alxlab-zone66x/Macintosh-Comm-Slot-I-Ethernet-Card/kicad/Farallon EtherMac LC Comm Slot Card 10Base-T/Farallon EtherMac LC Comm Slot Card 10Base-T v1.0.kicad_sch

## KiCad design kicad/Farallon EtherMac LC Comm Slot Card 10Base-T/Farallon EtherMac LC Comm Slot Card 10Base-T v1.0.kicad_sch (2024-09-20, an earlier design)

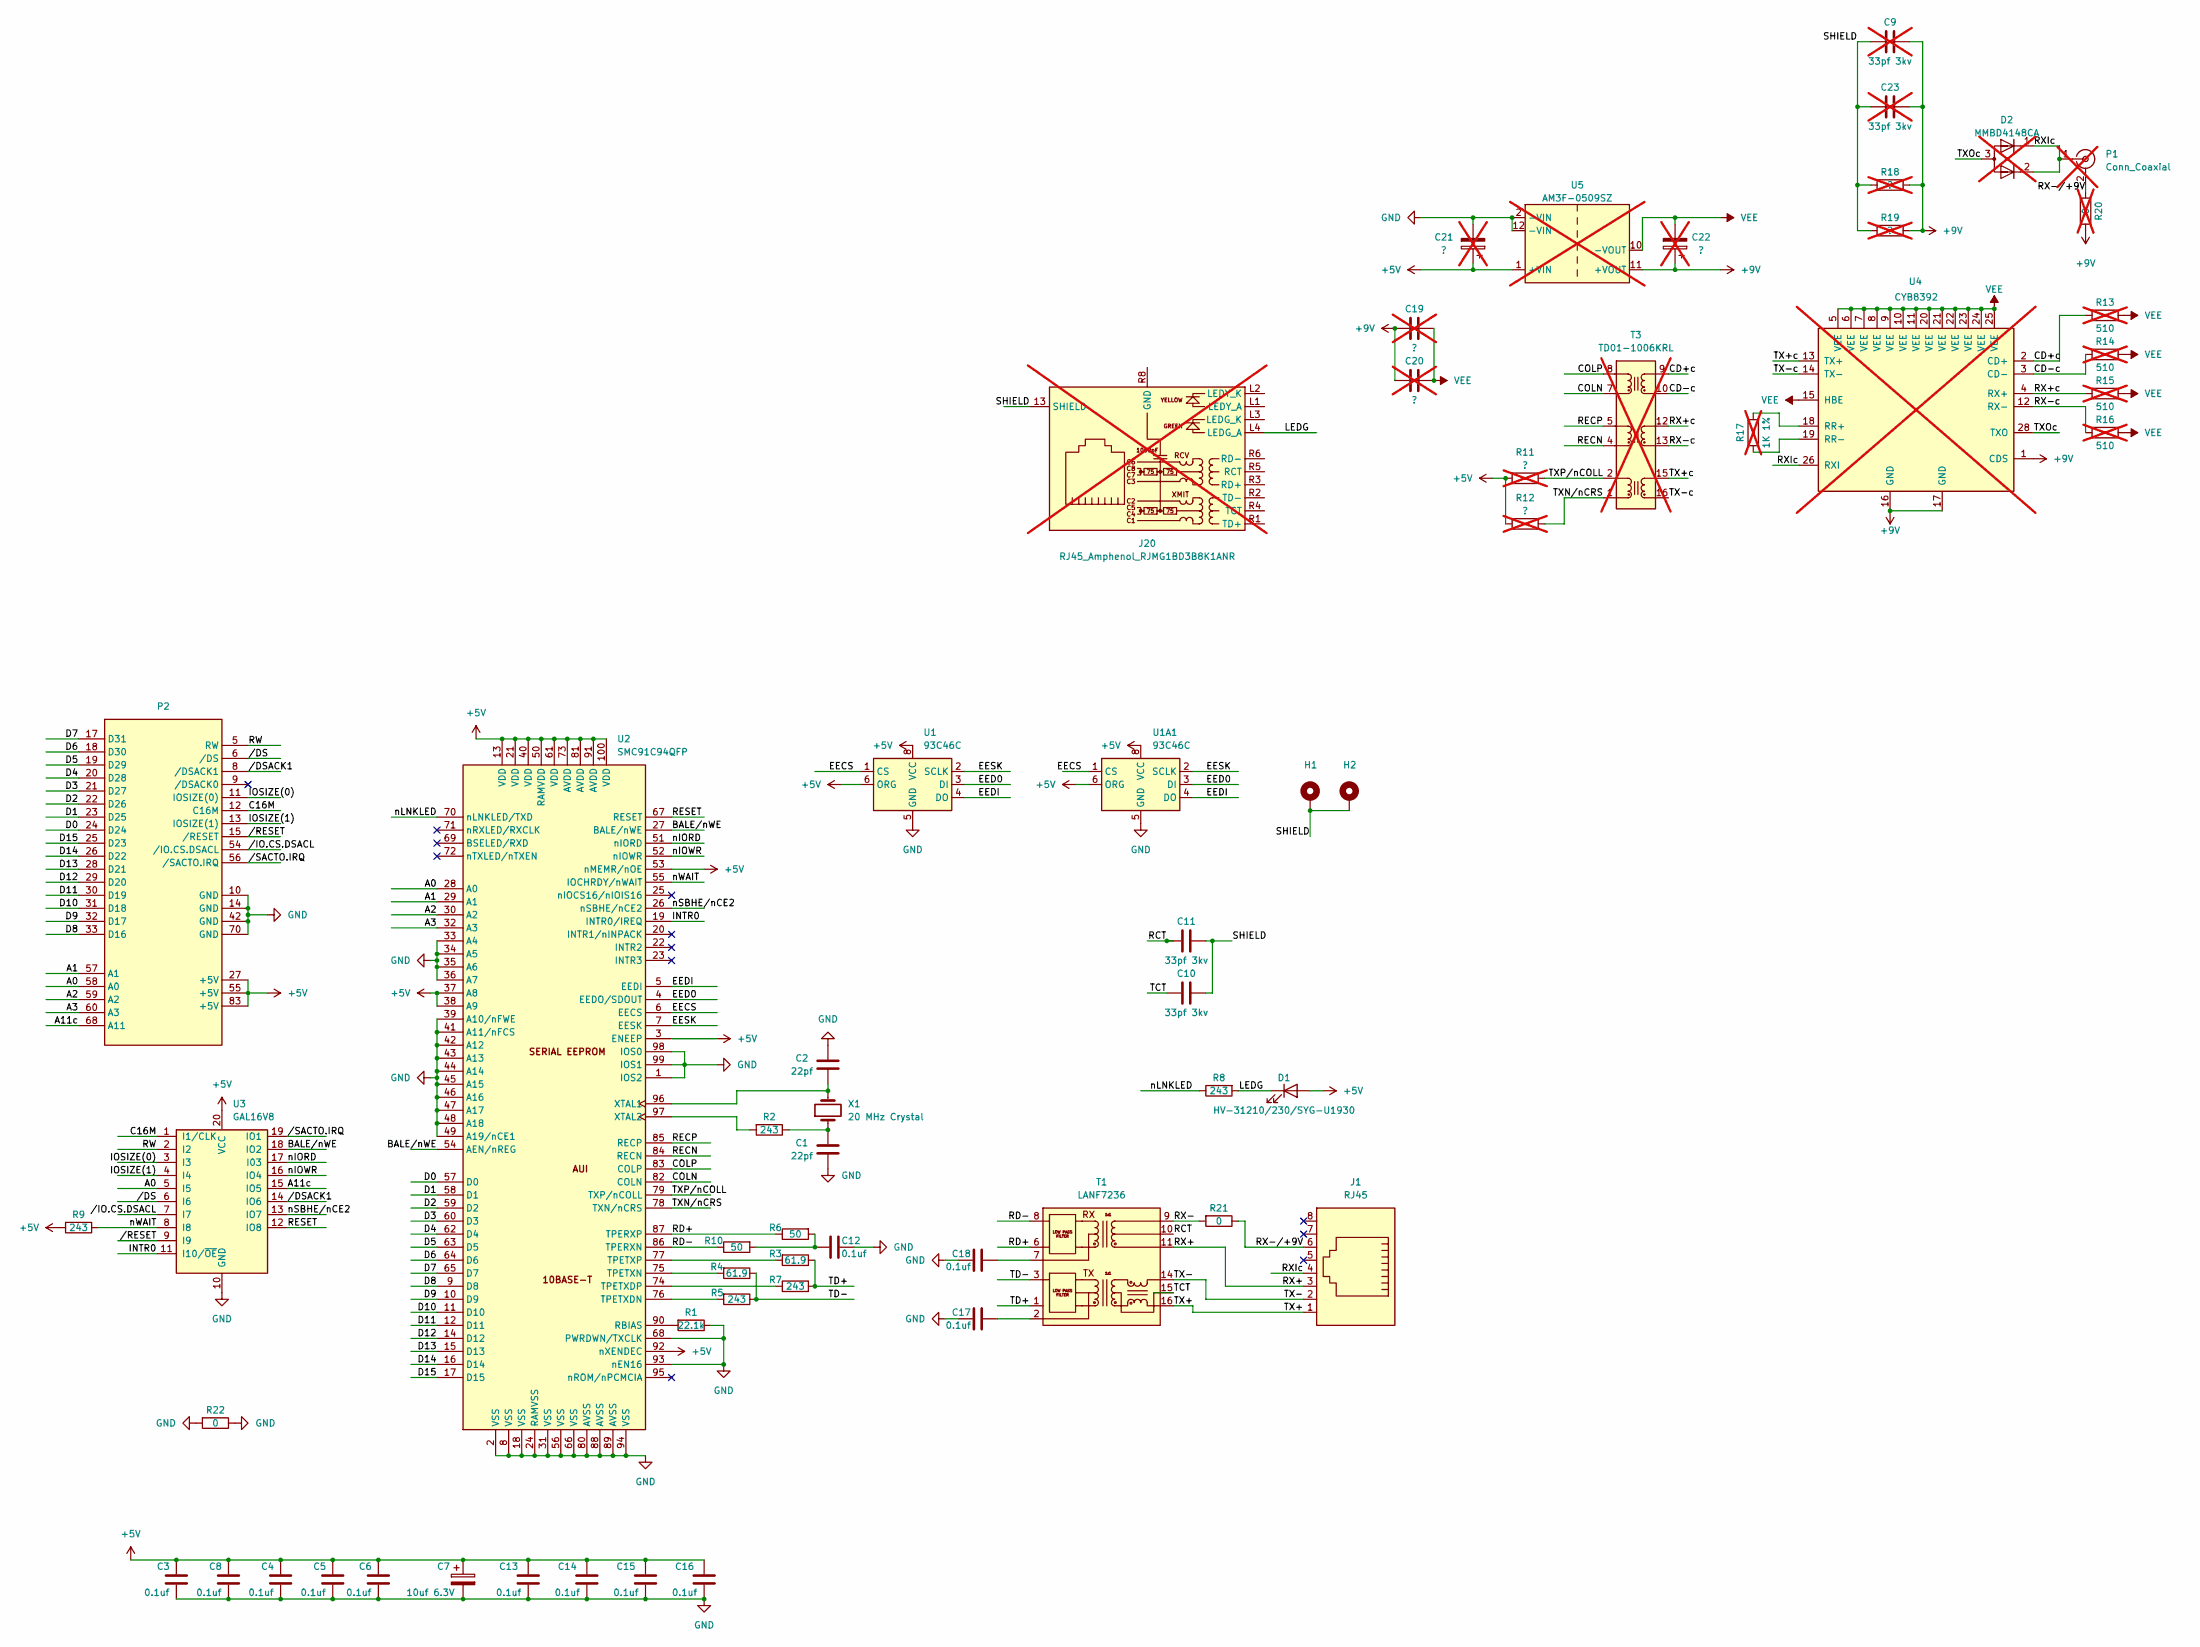
[picture p1: schematic Farallon EtherMac LC Comm Slot Card 10Base-T v1.0.kicad_sch]

Parts:
C1, C2: 22pf; Farallon_C_0603_1608Metric_Pad1.10x1.20mm_HandSolder; LCSC C1653
C3, C4, C5, C6, C8, C12, C13, C14, C15, C16, C17, C18: 0.1uf; Farallon_C_0603_1608Metric_Pad1.10x1.20mm_HandSolder; LCSC C14663
C7: 10uf 6.3V; Farallon_CP_EIA-3528-21_Kemet-B_Pad1.50x2.35mm_HandSolder; LCSC C7193
C9, C23: 33pf 3kv; C_Disc_D6.0mm_W2.5mm_P6.35mm; not fitted
C10, C11: 33pf 3kv; C_Disc_D6.0mm_W2.5mm_P6.35mm; LCSC C260735
C19, C20: ?; Farallon_C_0603_1608Metric_Pad1.10x1.20mm_HandSolder; not fitted
C21, C22: ?; Farallon_CP_Radial_D7.5mm_P3.0mm; not fitted
D1: HV-31210/230/SYG-U1930; LED_HV-31210-230-SYG-U1930; LCSC C473838
D2: MMBD4148CA; Farallon_SOT-23; not fitted
H1, H2: MountingHole_Pad; MountingHole_3.2mm_M3_ISO7380_Pad_TopBottom
J1: RJ45; Farallon_RJ45_BNC_Amphenol_54602-x08_Horizontal; Part 5555164-1; LCSC C2916457
J20: RJ45_Amphenol_RJMG1BD3B8K1ANR; not fitted
P1: Conn_Coaxial; Farallon_BNC_Adam-Tech_RF1-01A-D-00-75-M_Horizontal; not fitted
P2: Farallon_EtherMac_LC_Comm_Card_BUS_Apple_Macintos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; Farallon_EtherMac_LC_Comm_Card_BUS_Apple_Macintosh_Comm_Slo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
R1: 22.1k; Farallon_R_0603_1608Metric_Pad1.10x1.20mm_HandSolder; LCSC C25961
R2, R5, R7, R8, R9: 243; Farallon_R_0603_1608Metric_Pad1.10x1.20mm_HandSolder; LCSC C706060
R3, R4: 61.9; Farallon_R_0805_2012Metric_Pad1.40x1.40mm_HandSolder; LCSC C322537
R6, R10: 50; Farallon_R_0603_1608Metric_Pad1.10x1.20mm_HandSolder; LCSC C23185
R11, R12: ?; Farallon_R_0603_1608Metric_Pad1.10x1.20mm_HandSolder; not fitted
R13, R14, R15, R16: 510; Farallon_R_0603_1608Metric_Pad1.10x1.20mm_HandSolder; JLCPCB C23193; not fitted
R17: 1K 1%; Farallon_R_0603_1608Metric_Pad1.10x1.20mm_HandSolder; JLCPCB C21190; not fitted
R18, R19: ?; Farallon_R_1206_3216Metric_Pad1.65x1.65mm_HandSolder; not fitted
R20: 0; Farallon_R_0603_1608Metric_Pad1.10x1.20mm_HandSolder; JLCPCB C21189; not fitted
R21, R22: 0; Farallon_R_0603_1608Metric_Pad1.10x1.20mm_HandSolder; LCSC C21189
T1: LANF7236; Farallon_DIP-16_W7.62mm; LCSC C408876
T3: TD01-1006KRL; Farallon_DIP-16_W7.62mm; not fitted
U1: 93C46C; Farallon_SOIC-8_3.9x4.9mm_P1.27mm
U1A1: 93C46C; Farallon_DIP-8_W7.62mm; LCSC C5289485
U2: SMC91C94QFP; PQFP-100_14x20mm_P0.65mm_LongPad
U3: GAL16V8; Farallon_PLCC-20
U4: CYB8392; Farallon_PLCC-28; not fitted
U5: AM3F-0509SZ; Farallon_Converter_DCDC_Aimtec_AM3F-Z_THT; not fitted
X1: 20 MHz Crystal; Crystal_HC49-U_Vertical; LCSC C2848211

Connections:
+5V: C3.2, C4.2, C5.2, C6.2, C7.1, C8.2, C13.1, C14.2, C15.2, C16.2, C21.1, D1.2 (A), P2.27 (+5V), P2.55 (+5V), P2.83 (+5V), R9.2, R11.2, R12.2, U1.6 (ORG), U1.8 (VCC), U1A1.6 (ORG), U1A1.8 (VCC), U2.3 (ENEEP), U2.13 (VDD), U2.21 (VDD), U2.37 (A8), U2.38 (A9), U2.40 (VDD), U2.50 (RAMVDD), U2.53 (nMEMR/nOE), U2.61 (VDD), U2.73 (AVDD), U2.81 (AVDD), U2.91 (AVDD), U2.92 (nXENDEC), U2.100 (VDD), U3.20 (VCC), U5.1 (+VIN)
+9V: C9.2, C19.2, C20.1, C22.1, C23.2, R18.2, R19.2, R20.2, U4.1 (CDS), U4.16 (GND), U4.17 (GND), U5.11 (+VOUT)
A0: P2.58 (A0), U2.28 (A0), U3.5 (I5)
A1: P2.57 (A1), U2.29 (A1)
A2: P2.59 (A2), U2.30 (A2)
A3: P2.60 (A3), U2.32 (A3)
A11c: P2.68 (A11), U3.15 (IO5)
BALE/nWE: U2.27 (BALE/nWE), U2.54 (AEN/nREG), U3.18 (IO2)
C16M: P2.12 (C16M), U3.1 (I1/CLK)
CD+c: R13.2, T3.9 (TD3-), U4.2 (CD+)
CD-c: R14.2, T3.10 (TD3+), U4.3 (CD-)
COLN: T3.7 (MX3+), U2.82 (COLN)
COLP: T3.8 (MX3-), U2.83 (COLP)
D0: P2.24 (D24), U2.57 (D0)
D1: P2.23 (D25), U2.58 (D1)
D2: P2.22 (D26), U2.59 (D2)
D3: P2.21 (D27), U2.60 (D3)
D4: P2.20 (D28), U2.62 (D4)
D5: P2.19 (D29), U2.63 (D5)
D6: P2.18 (D30), U2.64 (D6)
D7: P2.17 (D31), U2.65 (D7)
D8: P2.33 (D16), U2.9 (D8)
D9: P2.32 (D17), U2.10 (D9)
D10: P2.31 (D18), U2.11 (D10)
D11: P2.30 (D19), U2.12 (D11)
D12: P2.29 (D20), U2.14 (D12)
D13: P2.28 (D21), U2.15 (D13)
D14: P2.26 (D22), U2.16 (D14)
D15: P2.25 (D23), U2.17 (D15)
EECS: U1.1 (CS), U1A1.1 (CS), U2.6 (EECS)
EED0: U1.3 (DI), U1A1.3 (DI), U2.4 (EEDO/SDOUT)
EEDI: U1.4 (DO), U1A1.4 (DO), U2.5 (EEDI)
EESK: U1.2 (SCLK), U1A1.2 (SCLK), U2.7 (EESK)
GND: C1.2, C2.1, C3.1, C4.1, C5.1, C6.1, C7.2, C8.1, C12.2, C13.2, C14.1, C15.1, C16.1, C17.2, C18.2, C21.2, P2.10 (GND), P2.14 (GND), P2.42 (GND), P2.70 (GND), R1.1, R22.1, R22.2, U1.5 (GND), U1A1.5 (GND), U2.1 (IOS2), U2.2 (VSS), U2.8 (VSS), U2.18 (VSS), U2.24 (RAMVSS), U2.31 (VSS), U2.33 (A4), U2.34 (A5), U2.35 (A6), U2.36 (A7), U2.39 (A10/nFWE), U2.41 (A11/nFCS), U2.42 (A12), U2.43 (A13), U2.44 (A14), U2.45 (A15), U2.46 (A16), U2.47 (A17), U2.48 (A18), U2.49 (A19/nCE1), U2.56 (VSS), U2.66 (VSS), U2.68 (PWRDWN/TXCLK), U2.80 (AVSS), U2.88 (AVSS), U2.89 (AVSS), U2.93 (nEN16), U2.94 (VSS), U2.98 (IOS0), U2.99 (IOS1), U3.10 (GND), U5.2 (-VIN), U5.12 (-VIN)
INTR0: U2.19 (INTR0/IREQ), U3.11 (I10/~OE)
IOSIZE(0): P2.11 (IOSIZE(0)), U3.3 (I3)
IOSIZE(1): P2.13 (IOSIZE(1)), U3.4 (I4)
LEDG: D1.1 (K), J20.L4 (LEDG_A), R8.2
unnamed: C1.1, R2.1, X1.1
unnamed: C2.2, U2.96 (XTAL1), X1.2
unnamed: C12.1, R6.2, R10.2
unnamed: C17.1, T1.2 (C_TD)
unnamed: C18.1, T1.7 (C_RD)
unnamed: R1.2, U2.90 (RBIAS)
unnamed: R2.2, U2.97 (XTAL2)
unnamed: R3.2, U2.77 (TPETXP)
unnamed: R4.2, U2.75 (TPETXN)
unnamed: R5.2, U2.76 (TPETXDN)
unnamed: R7.1, U2.74 (TPETXDP)
unnamed: R17.1, U4.19 (RR-)
unnamed: R17.2, U4.18 (RR+)
RCT: C11.2, T1.10 (C_RX)
RD+: R6.1, T1.6 (RD+), U2.87 (TPERXP)
RD-: R10.1, T1.8 (RD-), U2.86 (TPERXN)
RECN: T3.4 (MX2+), U2.84 (RECN)
RECP: T3.5 (MX2-), U2.85 (RECP)
RESET: U2.67 (RESET), U3.12 (IO8)
RW: P2.5 (RW), U3.2 (I2)
RX+: J1.3, T1.11 (RX+)
RX+c: R15.2, T3.12 (TD2-), U4.4 (RX+)
RX-: R21.2, T1.9 (RX-)
RX-c: R16.2, T3.13 (TD2+), U4.12 (RX-)
RX-/+9V: J1.6, P1.2 (Ext), R20.1, R21.1
RXIc: D2.1 (K), D2.2 (K), J1.4, P1.1 (In), U4.26 (RXI)
SHIELD: C9.1, C10.1, C11.1, C23.1, H1.1, H2.1, J20.13 (SHIELD), R18.1, R19.1
TCT: C10.2, T1.15 (C_TX)
TD+: R3.1, R7.2, T1.1 (TD+)
TD-: R4.1, R5.1, T1.3 (TD-)
TX+: J1.1, T1.16 (TX+)
TX+c: T3.15 (TD1-), U4.13 (TX+)
TX-: J1.2, T1.14 (TX-)
TX-c: T3.16 (TD1+), U4.14 (TX-)
TXN/nCRS: R12.1, T3.1 (MX1+), U2.78 (TXN/nCRS)
TXOc: D2.3 (A), U4.28 (TXO)
TXP/nCOLL: R11.1, T3.2 (MX1-), U2.79 (TXP/nCOLL)
VEE: C19.1, C20.2, C22.2, R13.1, R14.1, R15.1, R16.1, U4.5 (VEE), U4.6 (VEE), U4.7 (VEE), U4.8 (VEE), U4.9 (VEE), U4.10 (VEE), U4.11 (VEE), U4.15 (HBE), U4.20 (VEE), U4.21 (VEE), U4.22 (VEE), U4.23 (VEE), U4.24 (VEE), U4.25 (VEE), U5.9 (NC), U5.10 (-VOUT)
nIORD: U2.51 (nIORD), U3.17 (I03)
nIOWR: U2.52 (nIOWR), U3.16 (IO4)
nLNKLED: R8.1, U2.70 (nLNKLED/TXD)
nSBHE/nCE2: U2.26 (nSBHE/nCE2), U3.13 (IO7)
nWAIT: R9.1, U2.55 (IOCHRDY/nWAIT), U3.8 (I8)
/DS: P2.6 (/DS), U3.6 (I6)
/DSACK1: P2.8 (/DSACK1), U3.14 (IO6)
/IO.CS.DSACL: P2.54 (/IO.CS.DSACL), U3.7 (I7)
/RESET: P2.15 (/RESET), U3.9 (I9)
/SACTO.IRQ: P2.56 (/SACTO.IRQ), U3.19 (IO1)
