alxlab-zone66x/Macintosh-Comm-Slot-I-Ethernet-Card/(commit log)

2024-09-11 Add submodule for alxlab Kicad library
2024-09-20 Add kicad files
    Add alxlab Kicad library git submodule
    [Farallon EtherMac LC Comm Slot Card 10Base-T Bracket v1.2.kicad_pcb, Farallon EtherMac LC Comm Slot Card 10Base-T Bracket v1.2.kicad_sch, Farallon EtherMac LC Comm Slot Card 10Base-T Bracket.kicad_pcb, Farallon EtherMac LC Comm Slot Card 10Base-T Bracket.kicad_sch, Farallon EtherMac LC Comm Slot Card 10Base-T v1.0.kicad_sch, Farallon EtherMac LC Comm Slot Card 10Base-T v1.1.kicad_sch, Farallon Et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]
